reubenstr/CurrentWeather/README.md

# CurrentWeather
 
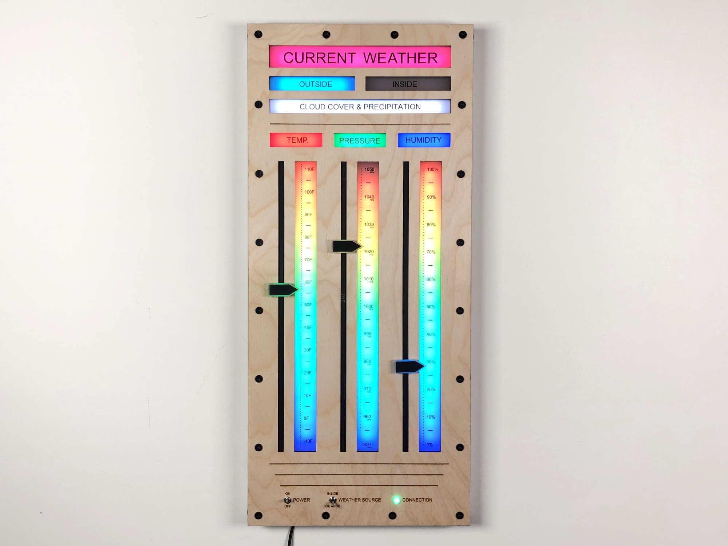
[picture p1: images/current-weather-front.jpg]


Displays current weather conditions using three mechanical gauges via Wi-Fi enabled ESP32.
