reubenstr/CurrentWeather/images/current-weather-back.jpg

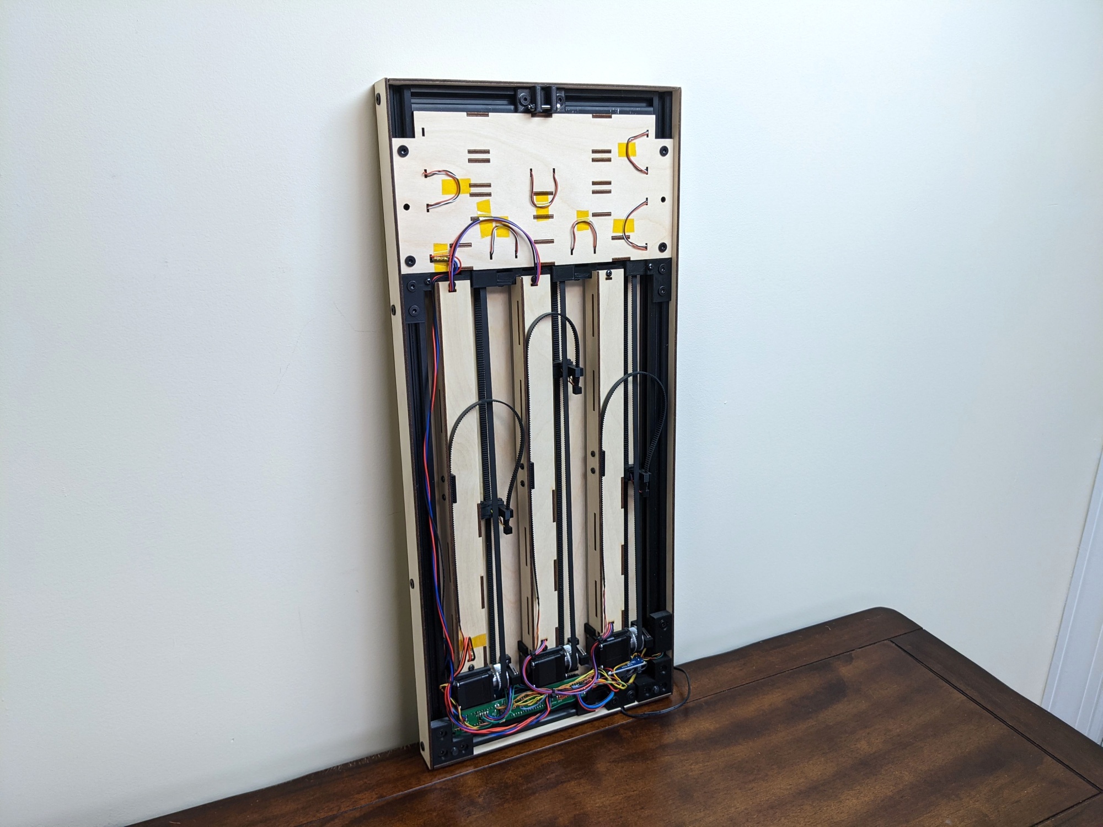
images/current-weather-back.jpg
