reubenstr/CurrentWeather/images/current-weather-cable-drag-chain-combo.jpg

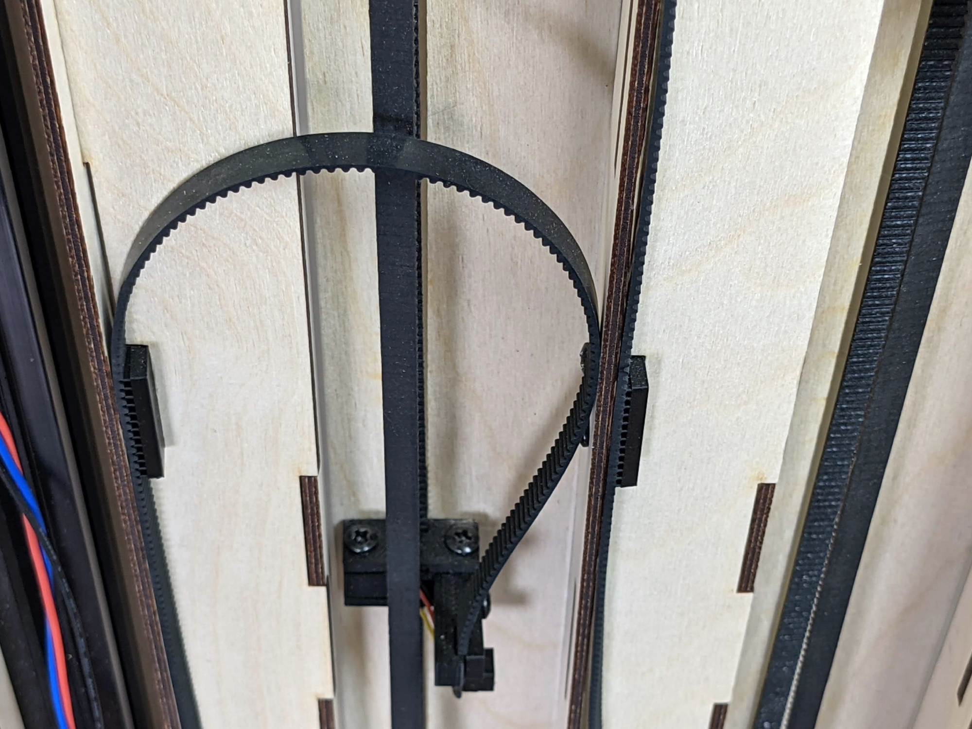
images/current-weather-cable-drag-chain-combo.jpg
