reubenstr/CurrentWeather/images/current-weather-cable-dragchain-termination.jpg

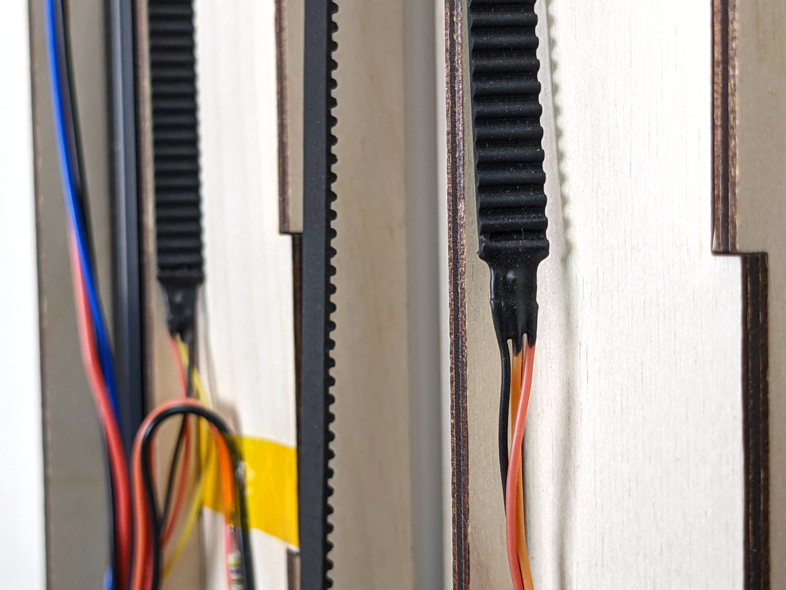
images/current-weather-cable-dragchain-termination.jpg
