reubenstr/CurrentWeather/images/current-weather-controls.jpg

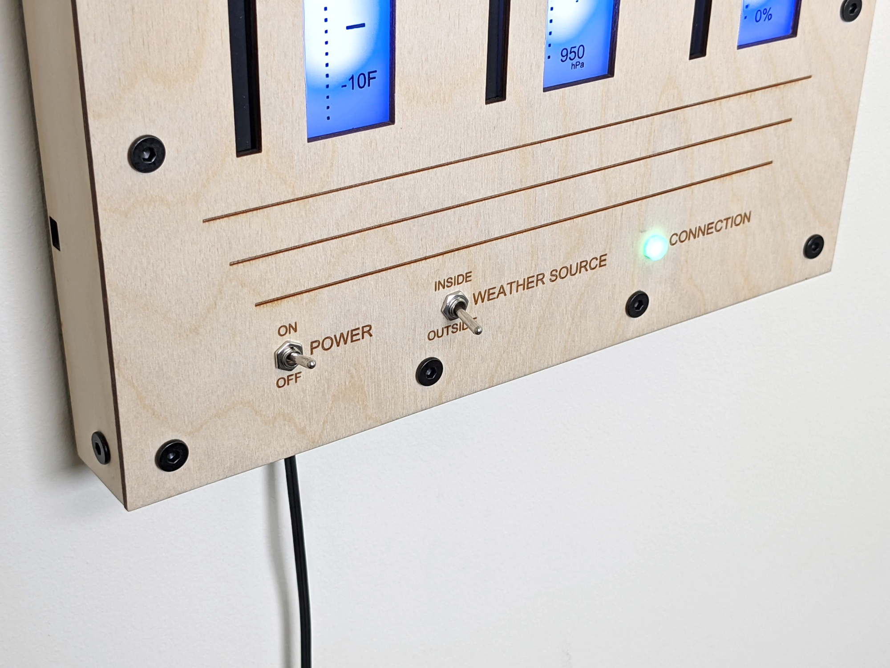
images/current-weather-controls.jpg
