reubenstr/CurrentWeather/images/current-weather-electronics-area.jpg

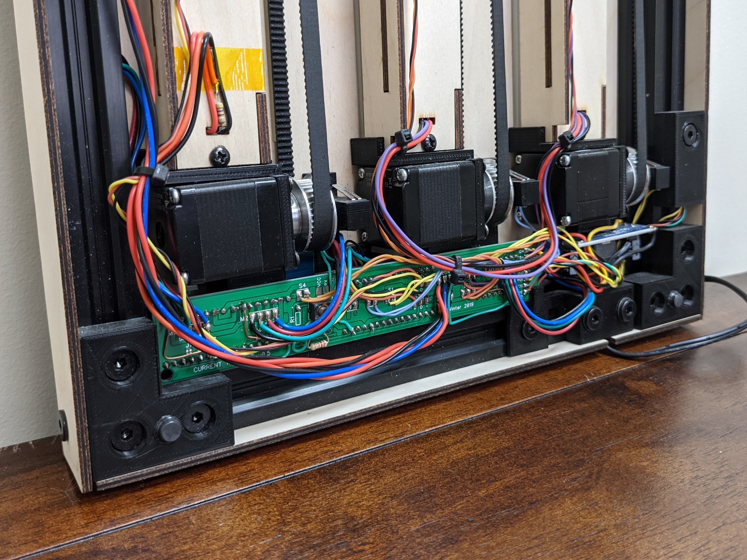
images/current-weather-electronics-area.jpg
