reubenstr/CurrentWeather/images/current-weather-frame-wall-mounting-bracket.jpg

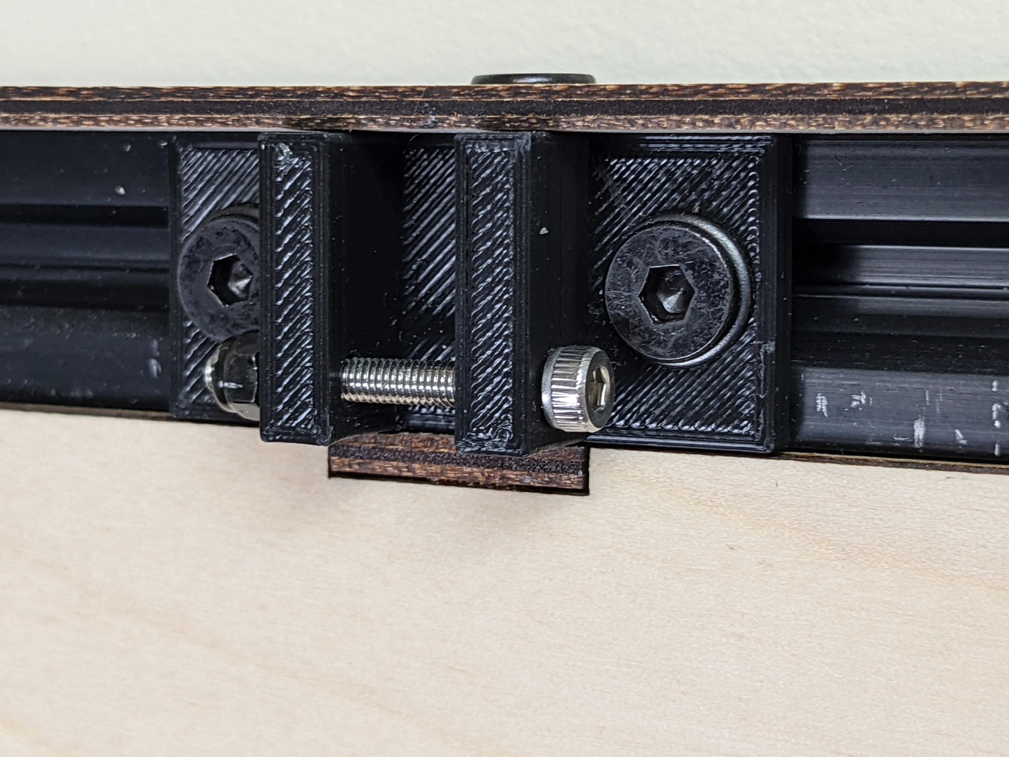
images/current-weather-frame-wall-mounting-bracket.jpg
