reubenstr/CurrentWeather/images/current-weather-front-turned-off.jpg

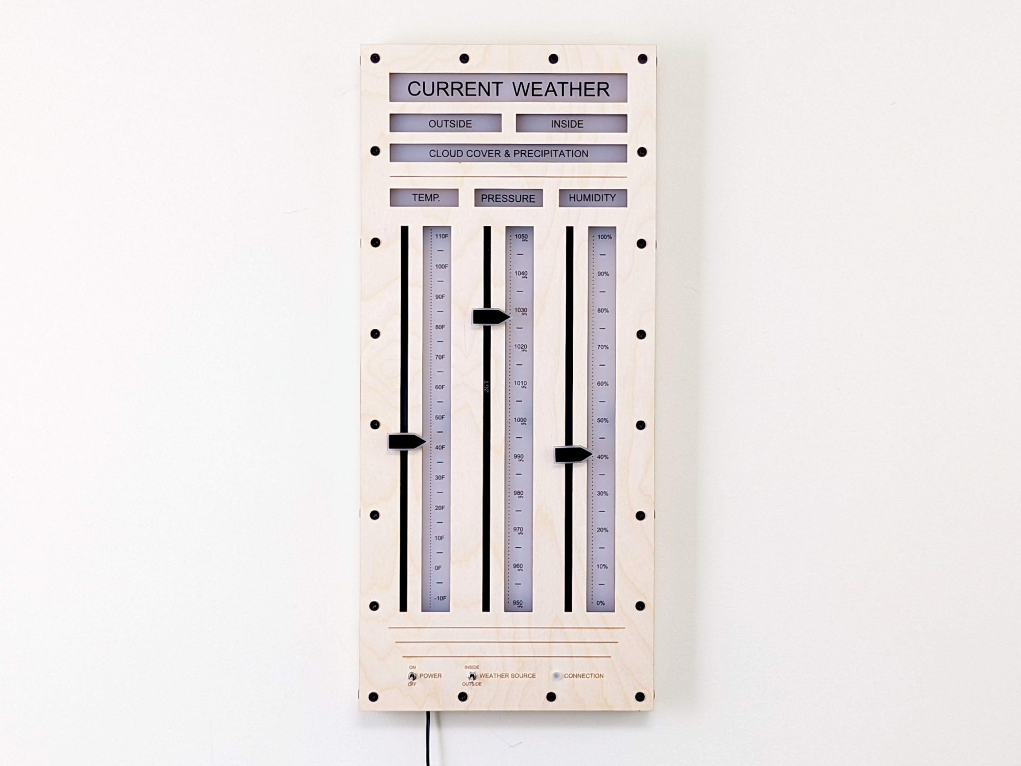
images/current-weather-front-turned-off.jpg
