reubenstr/CurrentWeather/images/current-weather-indicator-at-index-switch.jpg

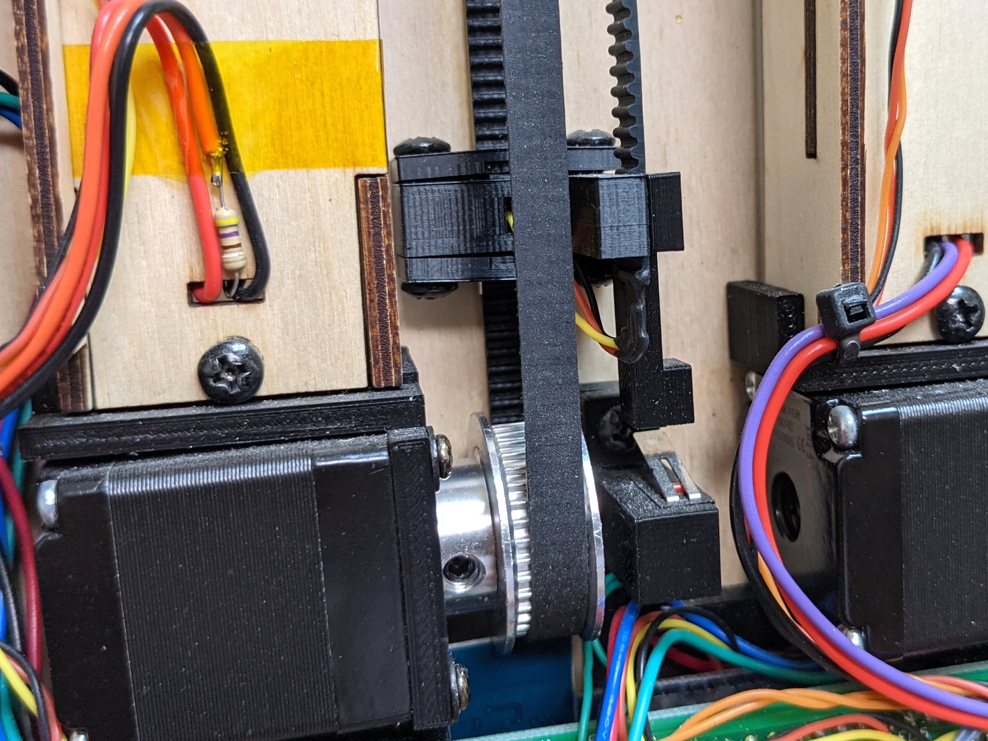
images/current-weather-indicator-at-index-switch.jpg
