reubenstr/CurrentWeather/images/current-weather-indicator-upclose.jpg

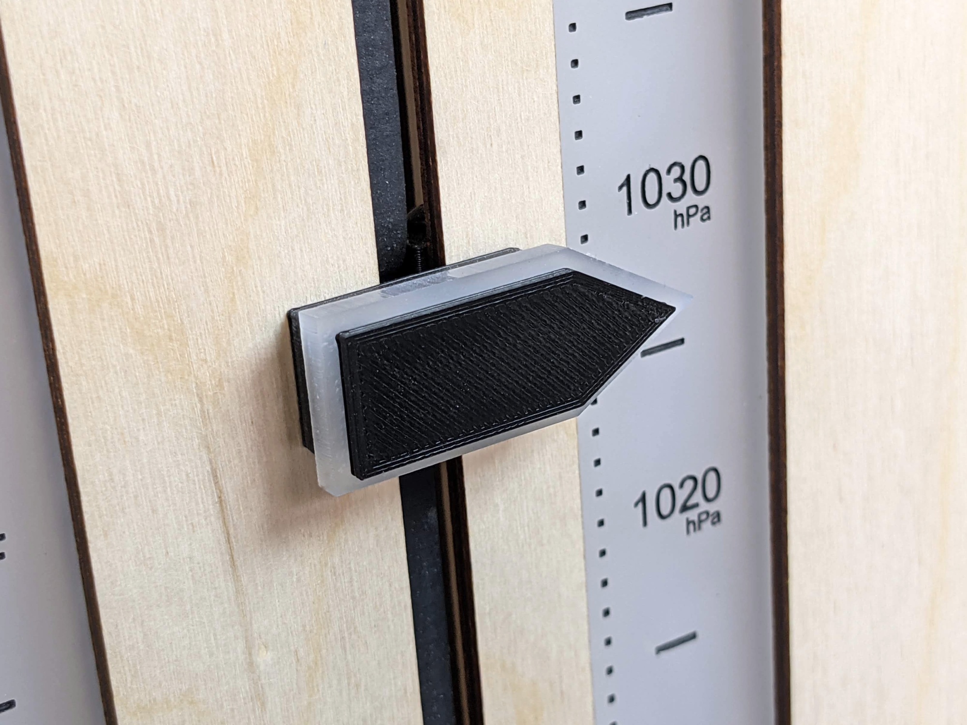
images/current-weather-indicator-upclose.jpg
