reubenstr/CurrentWeather/images/current-weather-onboard-sensor.jpg

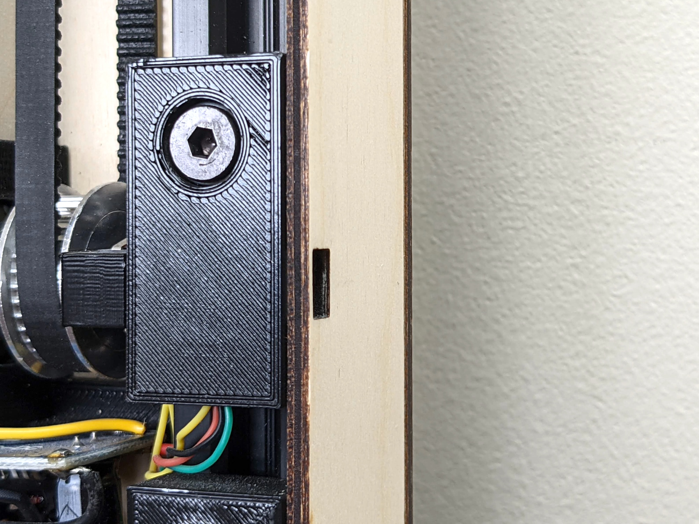
images/current-weather-onboard-sensor.jpg
