reubenstr/CurrentWeather/images/current-weather-pcb-rear.jpg

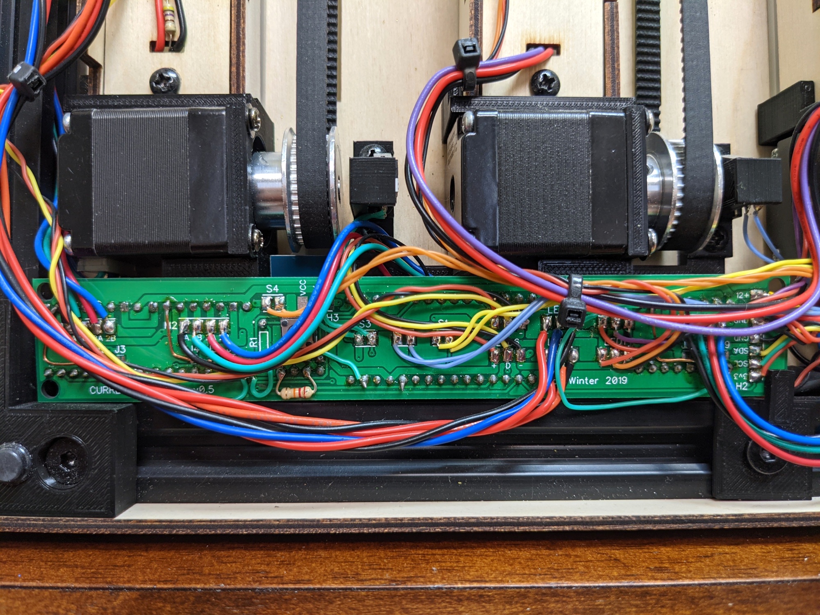
images/current-weather-pcb-rear.jpg
