reubenstr/CurrentWeather/images/current-weather-schematic.png

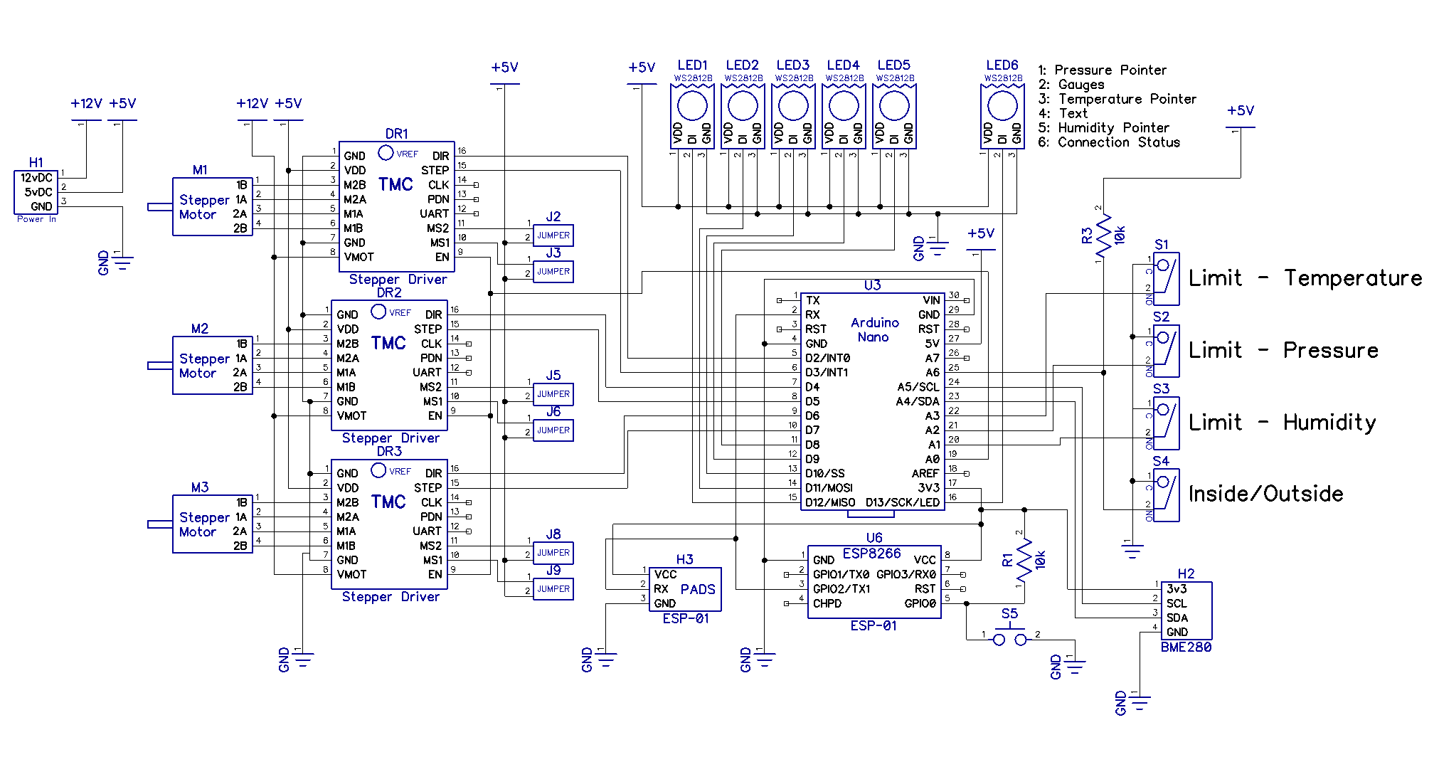
images/current-weather-schematic.png
