reubenstr/CurrentWeather/images/current-weather-side-closeup.jpg

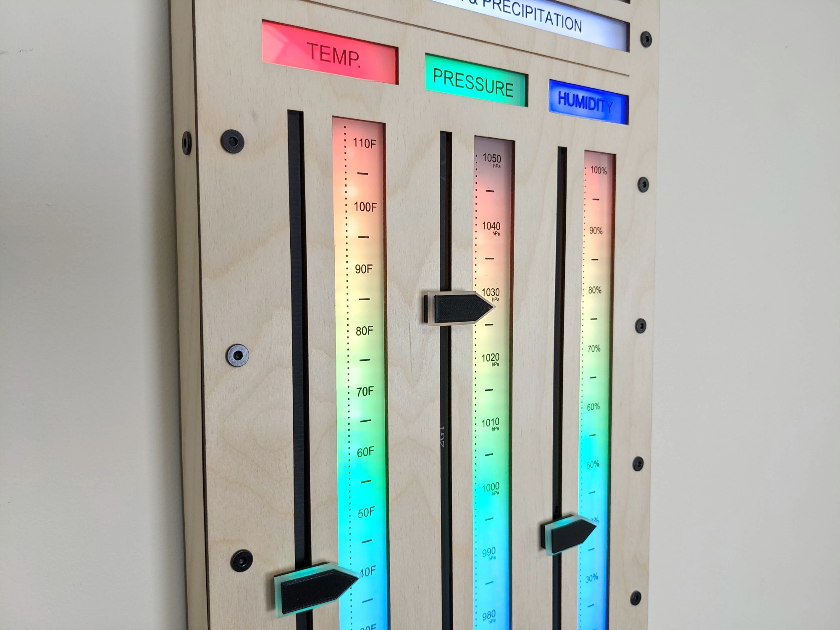
images/current-weather-side-closeup.jpg
