reubenstr/CurrentWeather/images/current-weather-side.jpg

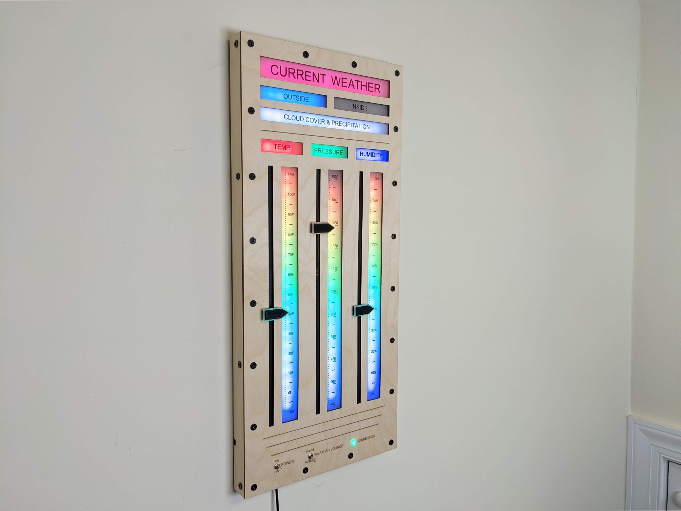
images/current-weather-side.jpg
