reubenstr/CurrentWeather/images/current-weather-stepper.jpg

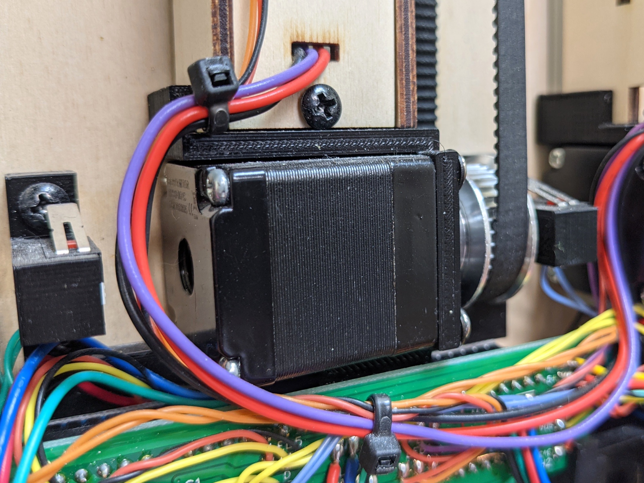
images/current-weather-stepper.jpg
