reubenstr/CurrentWeather/images/current-weather-top-back-panel.jpg

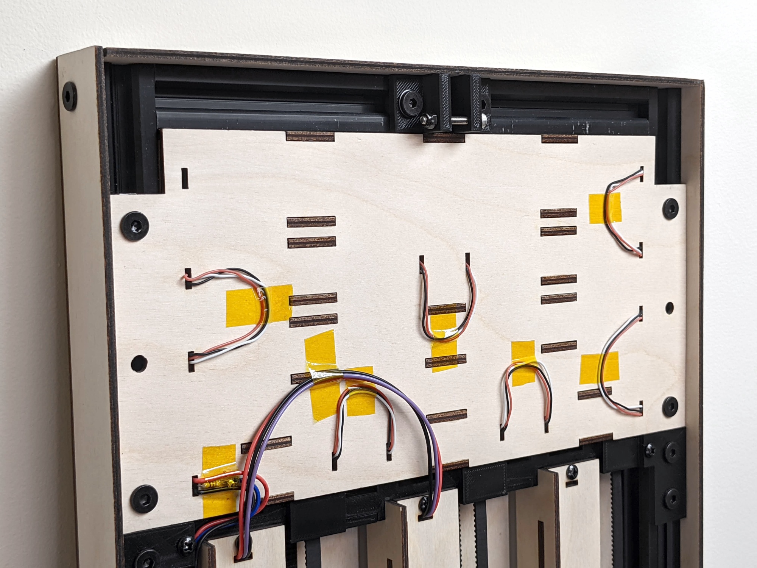
images/current-weather-top-back-panel.jpg
