reubenstr/CurrentWeather/images/current-weather-top-belt-idler-angle.jpg

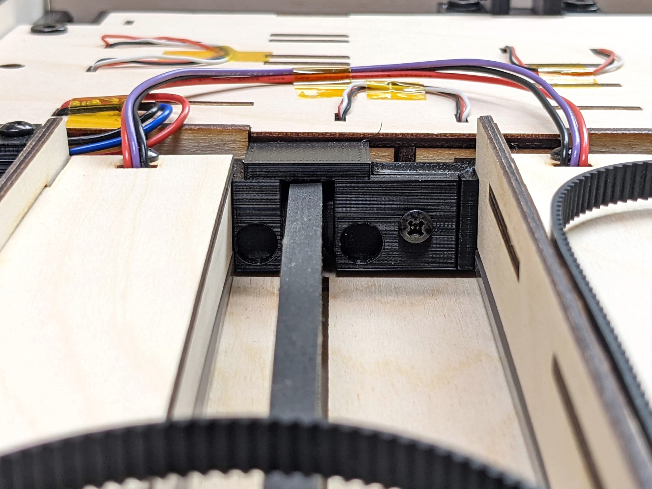
images/current-weather-top-belt-idler-angle.jpg
