reubenstr/CurrentWeather/images/current-weather-top-belt-idler.jpg

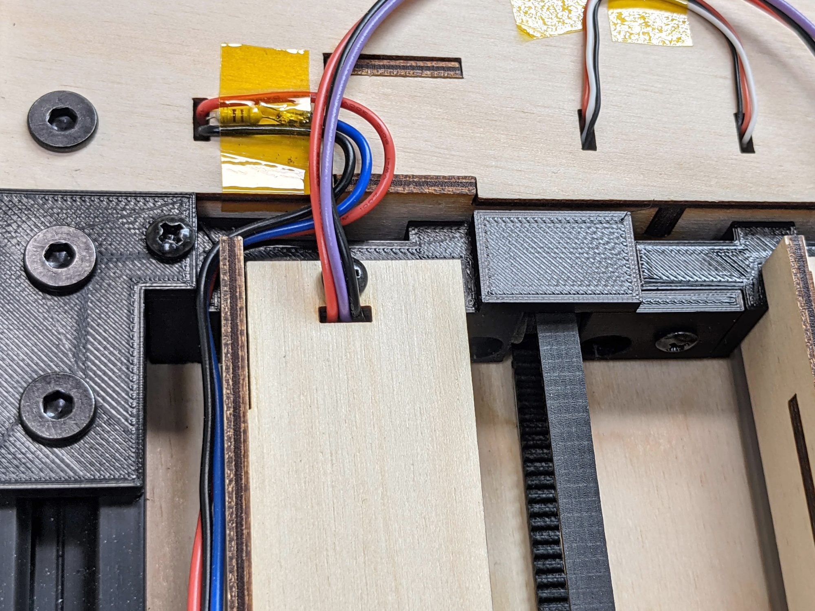
images/current-weather-top-belt-idler.jpg
