reubenstr/CurrentWeather/images/current-weather-upclose-engraving.jpg

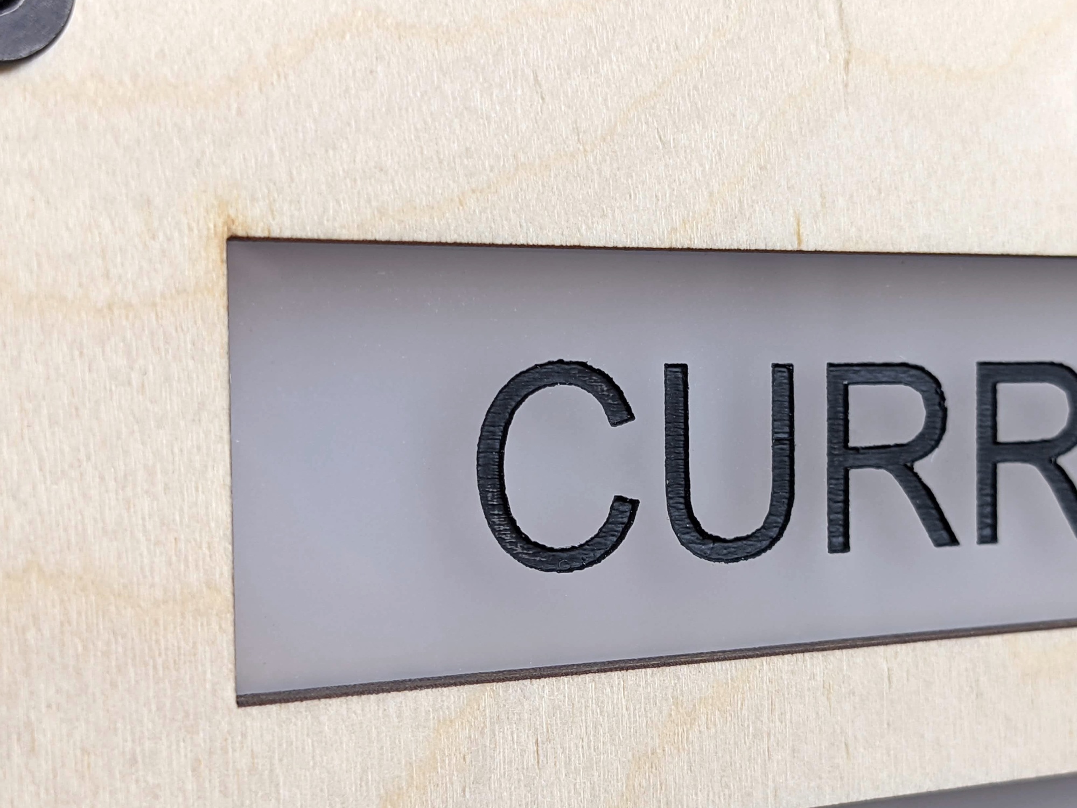
images/current-weather-upclose-engraving.jpg
