reubenstr/CurrentWeather/stl/Weather Station Parts (17).stl

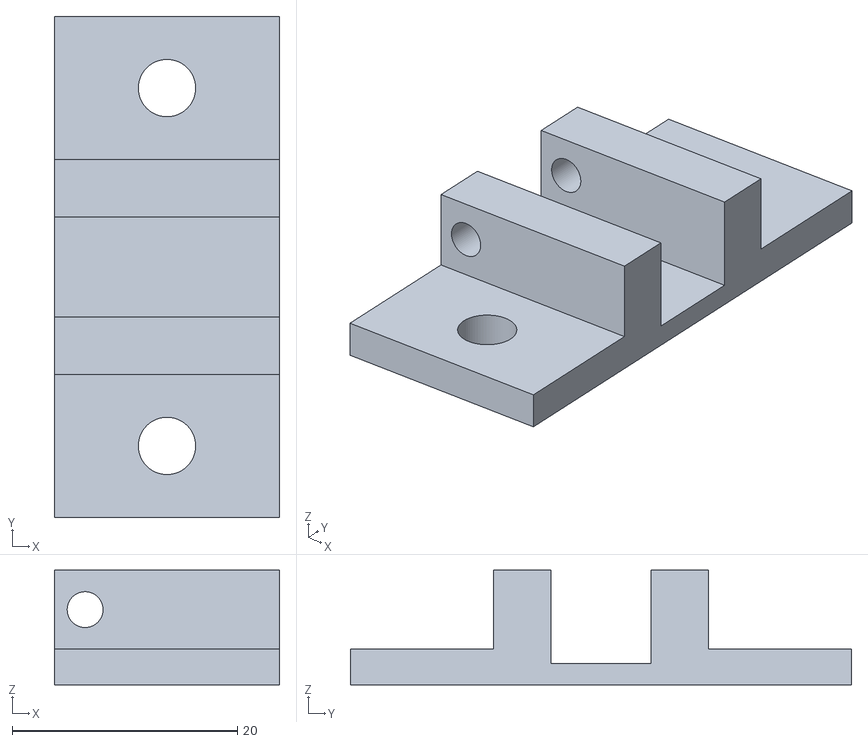
[picture p21: CAD file, 2021-03-08]
stl/Weather Station Parts (17).stl
20.0 x 44.5 x 10.2
