reubenstr/CurrentWeather/stl/Weather Station Parts (10).stl

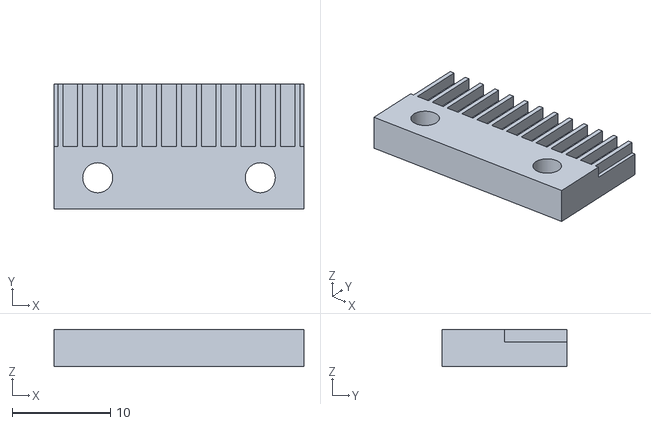
[picture p22: CAD file, 2021-03-08]
stl/Weather Station Parts (10).stl
25.4 x 12.7 x 3.81
