reubenstr/CurrentWeather/stl/Weather Station Parts (12).stl

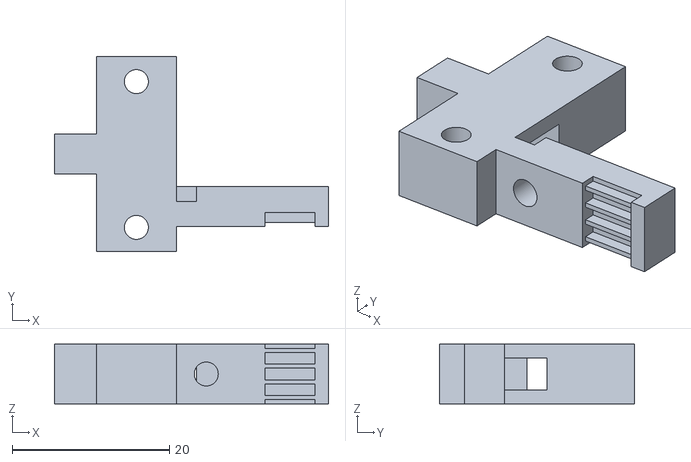
[picture p23: CAD file, 2021-03-08]
stl/Weather Station Parts (12).stl
34.8 x 24.8 x 7.62
