reubenstr/CurrentWeather/stl/Weather Station Parts (14).stl

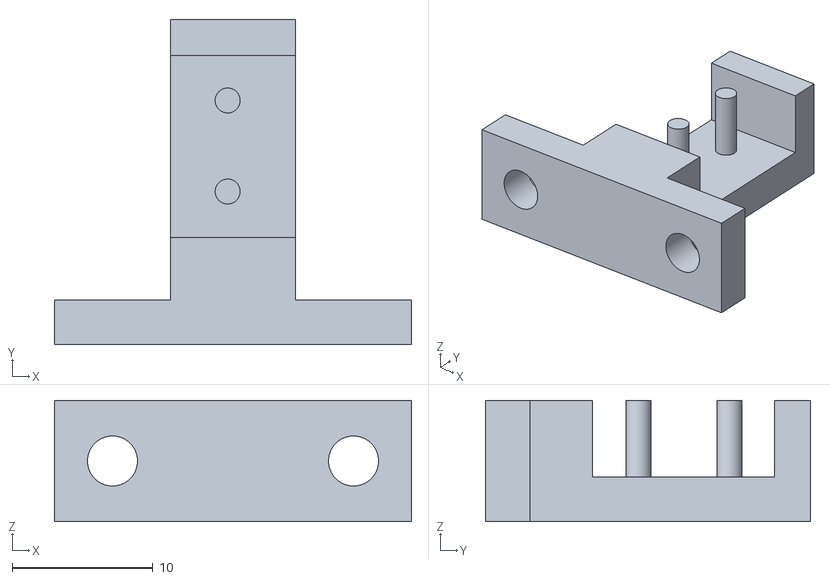
[picture p24: CAD file, 2021-03-08]
stl/Weather Station Parts (14).stl
25.4 x 23.1 x 8.64
