reubenstr/CurrentWeather/stl/Weather Station Parts (18).stl

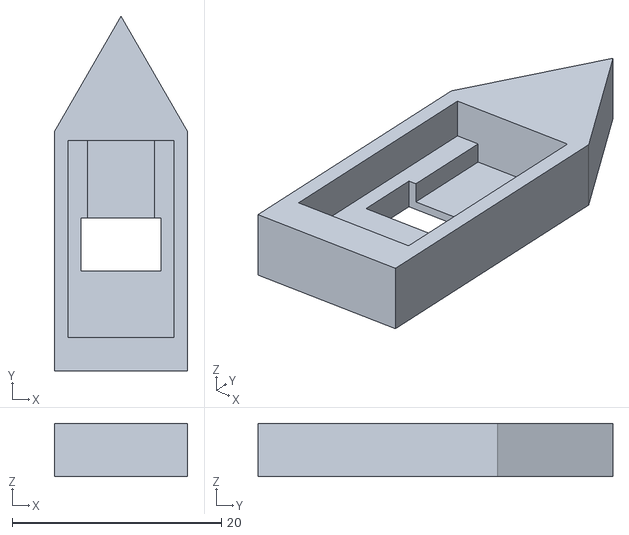
[picture p25: CAD file, 2021-03-08]
stl/Weather Station Parts (18).stl
12.7 x 33.9 x 5.08
