reubenstr/CurrentWeather/stl/Weather Station Parts (19).stl

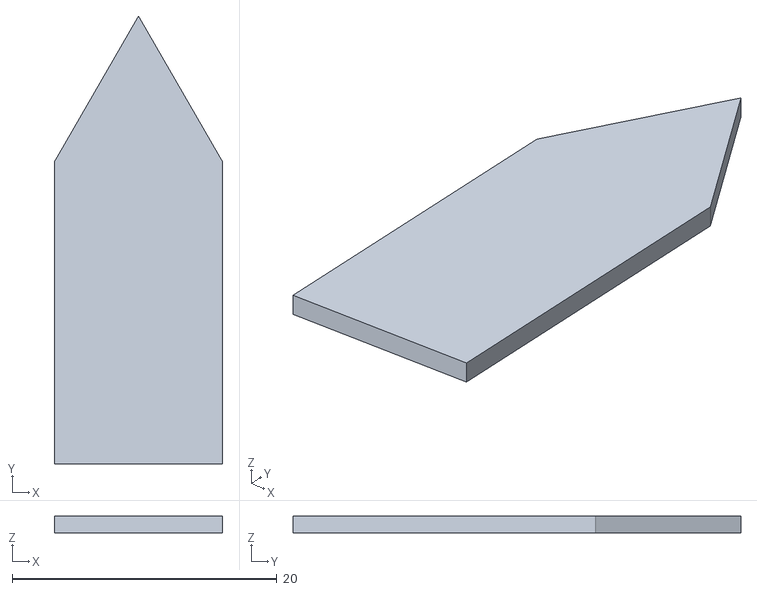
[picture p26: CAD file, 2021-03-08]
stl/Weather Station Parts (19).stl
12.7 x 33.9 x 1.27
