reubenstr/CurrentWeather/stl/Weather Station Parts (15).stl

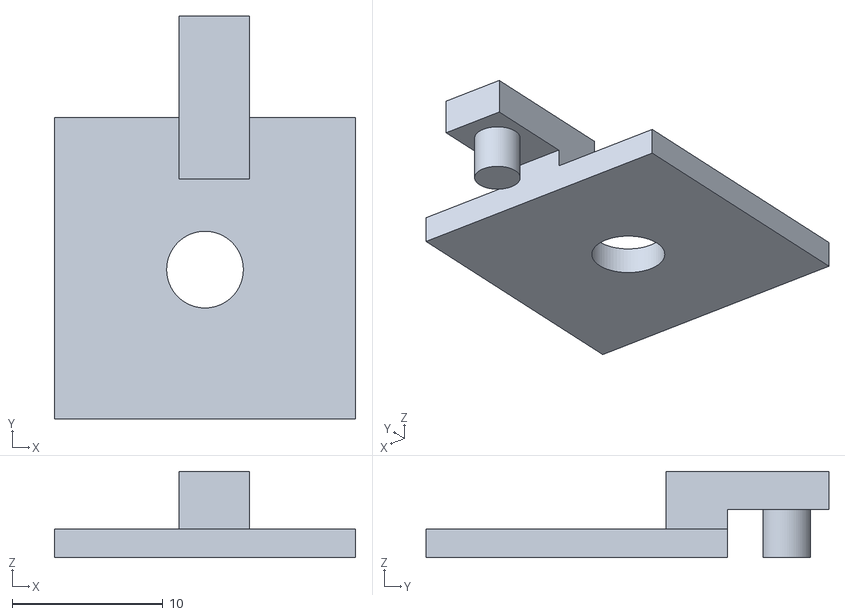
[picture p27: CAD file, 2021-03-08]
stl/Weather Station Parts (15).stl
20.0 x 26.7 x 5.72
