reubenstr/CurrentWeather/stl/Weather Station Parts.stl

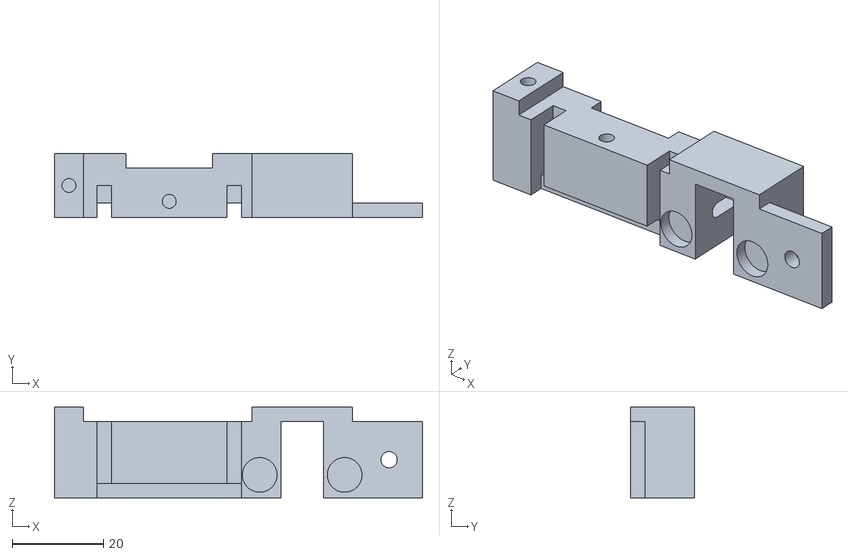
[picture p28: CAD file, 2021-03-08]
stl/Weather Station Parts.stl
80.9 x 14.0 x 20.0
