reubenstr/CurrentWeather/stl/Weather Station Parts (16).stl

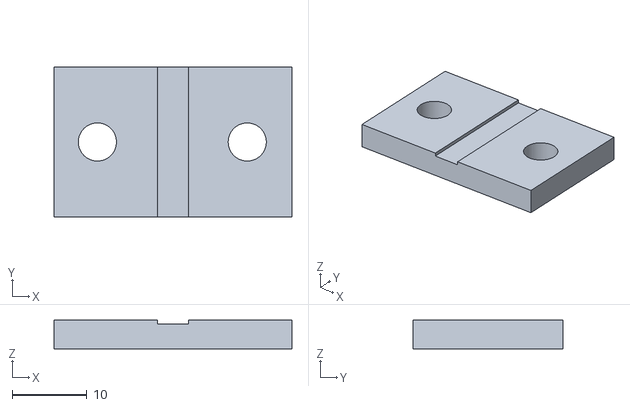
[picture p29: CAD file, 2021-03-08]
stl/Weather Station Parts (16).stl
31.8 x 20.0 x 3.81
