reubenstr/CurrentWeather/stl/Weather Station Parts (20).stl

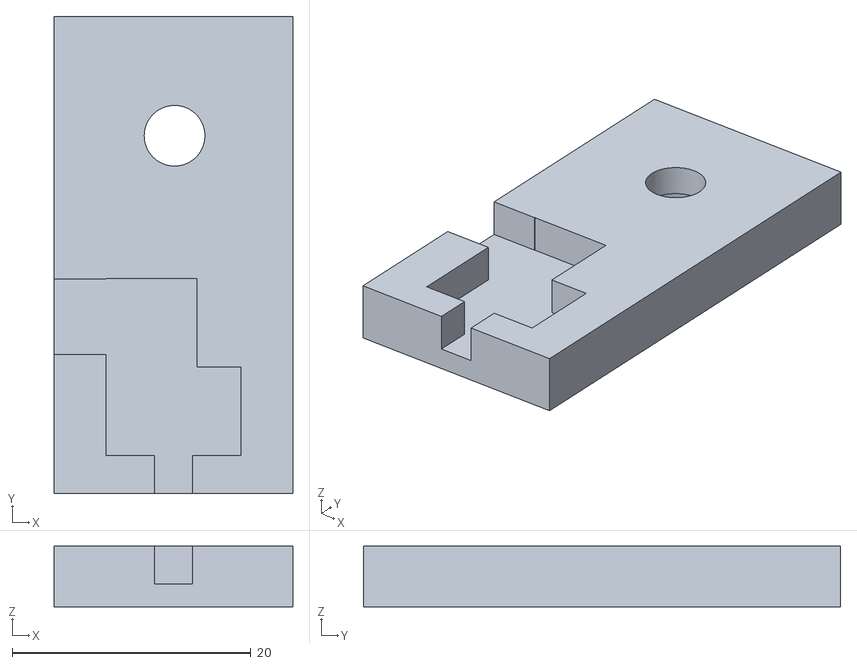
[picture p30: CAD file, 2021-03-08]
stl/Weather Station Parts (20).stl
20.0 x 40.0 x 5.08
