reubenstr/CurrentWeather/stl/Weather Station Parts (11).stl

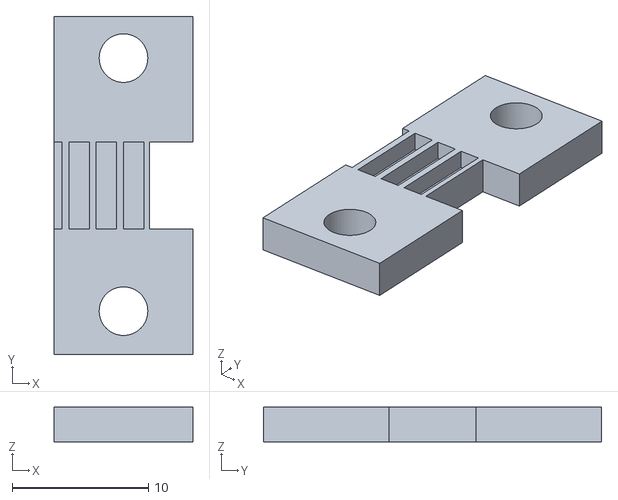
[picture p31: CAD file, 2021-03-08]
stl/Weather Station Parts (11).stl
10.2 x 24.8 x 2.54
