reubenstr/CurrentWeather/stl/Weather Station Parts (13).stl

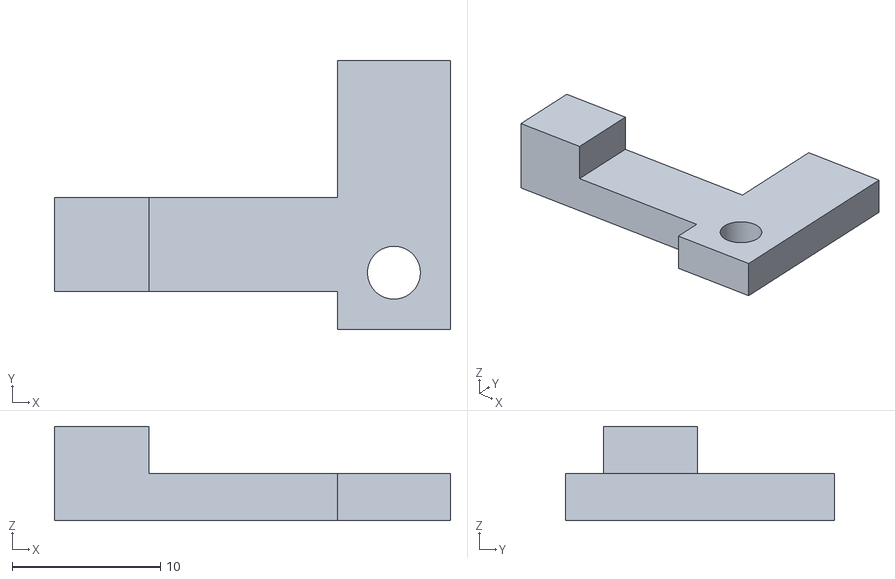
[picture p32: CAD file, 2021-03-08]
stl/Weather Station Parts (13).stl
26.7 x 18.1 x 6.35
