reubenstr/CurrentWeather/stl/Weather Station Parts (5).stl

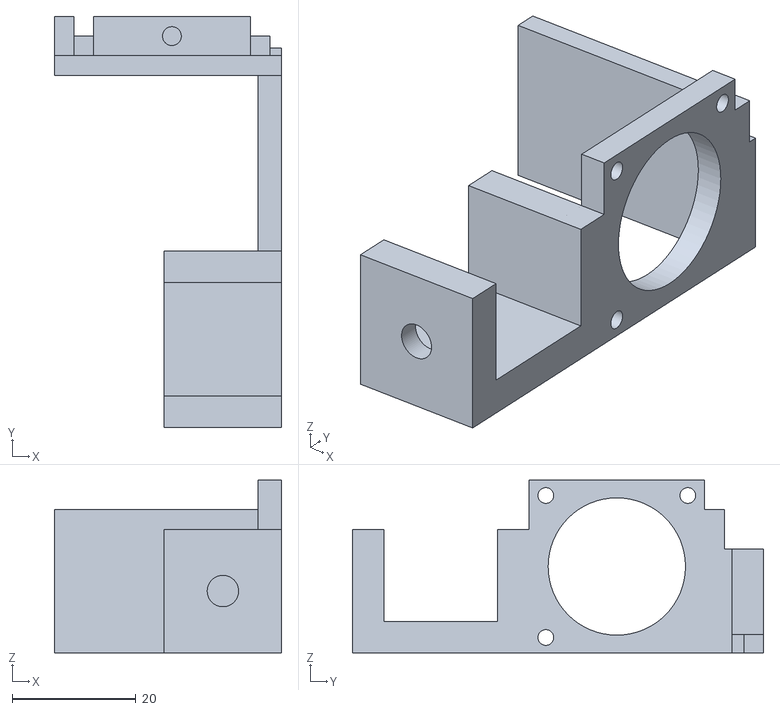
[picture p33: CAD file, 2021-03-08, an earlier design]
stl/Weather Station Parts (5).stl
36.8 x 66.5 x 27.9
