reubenstr/CurrentWeather/stl/Weather Station Parts (8).stl

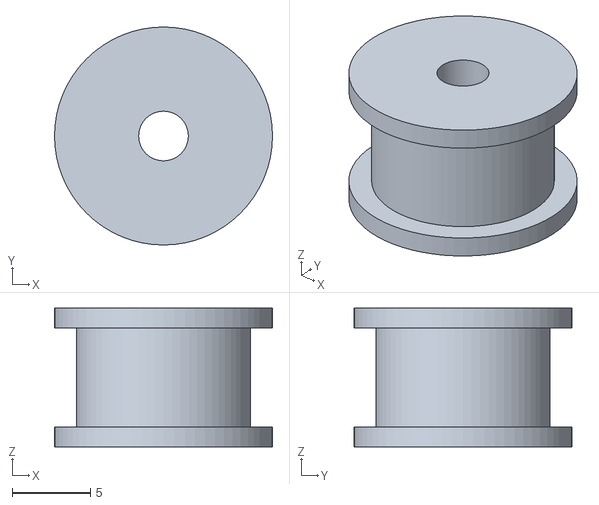
[picture p34: CAD file, 2021-03-08, an earlier design]
stl/Weather Station Parts (8).stl
14.0 x 14.0 x 8.89
