reubenstr/CurrentWeather/stl/Weather Station Parts (2).stl

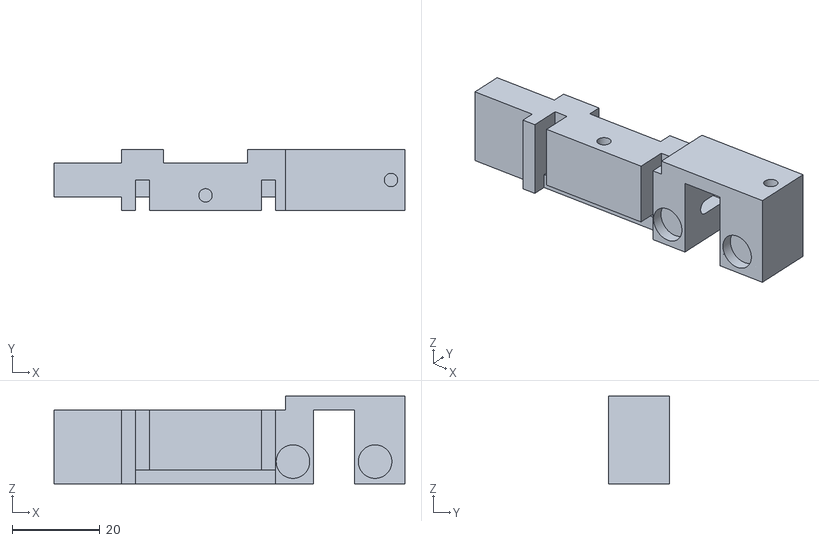
[picture p35: CAD file, 2021-03-08, an earlier design]
stl/Weather Station Parts (2).stl
79.8 x 14.0 x 20.0
