reubenstr/CurrentWeather/stl/Weather Station Parts (1).stl

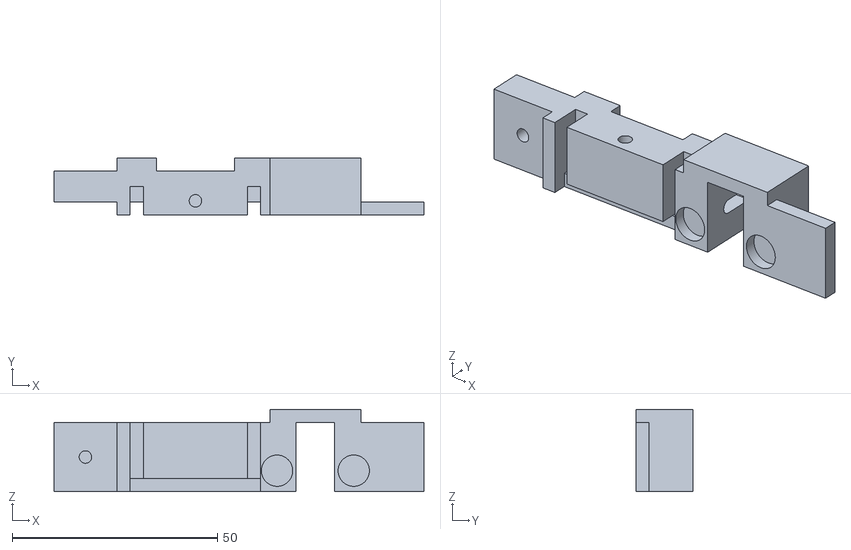
[picture p36: CAD file, 2021-03-08, an earlier design]
stl/Weather Station Parts (1).stl
90.1 x 14.0 x 20.0
