reubenstr/CurrentWeather/(list of files, cad)

Other CAD files:
cad/current-weather.dxf
stl/Weather Station Parts (21).stl
stl/Weather Station Parts (3).stl
stl/Weather Station Parts (4).stl
stl/Weather Station Parts (6).stl
stl/Weather Station Parts (7).stl
stl/Weather Station Parts (9).stl
