reubenstr/CurrentWeather/(list of files, drawings)

Other design files:
PCB/WeatherStation-pcb-layout.dip
PCB/WeatherStation-schematic.dch
