reubenstr/CurrentWeather/(commit log)

2019-12-29 File rework.
    [BoardOutline.gbr, Bottom.gbr, BottomAssy.gbr, BottomDimension.gbr, BottomMask.gbr, BottomPaste.gbr, BottomSilk.gbr, Through.drl]
2020-01-02 Progress with MCU code.
    [WeatherStation-3.dch]
2020-01-04 Motor position active. LED colors started.
    [WeatherStation-3.dch]
2020-01-08 Sensor connected. Adding data switch logic.
2020-01-08 BME280 sensor activates gauges.
2020-01-08 Odd bug: bmp280 stops updating inside data after 10ish seconds.
    [CurrentWeather-MCU.ino]
2020-01-08 Calibration added, cleaner logic.
2020-01-10 Code cleanup. Added weather demo's.
    [WeatherStation-3.dch]
2020-09-10 Added brightness to WiFi params.
    [WeatherStation-2.dch, WeatherStation-2.dip, WeatherStation-3.dip, WeatherStation-pcb-layout.dip, WeatherStation-schematic.dch, WeatherStation.dch, WeatherStation.dip]
2021-03-08 File uploads.
    [Weather Station Parts (1).stl, Weather Station Parts (10).stl, Weather Station Parts (11).stl, Weather Station Parts (12).stl, Weather Station Parts (13).stl, Weather Station Parts (14).stl, Weather Station Parts (15).stl, Weather Station Parts (16).stl]
